eSpark-Backup/chrisbyrd-lightsptdevice/Design Files/LightSPT-Device-v1.0/Deliverables/Renderings/2D_C_View.PNG

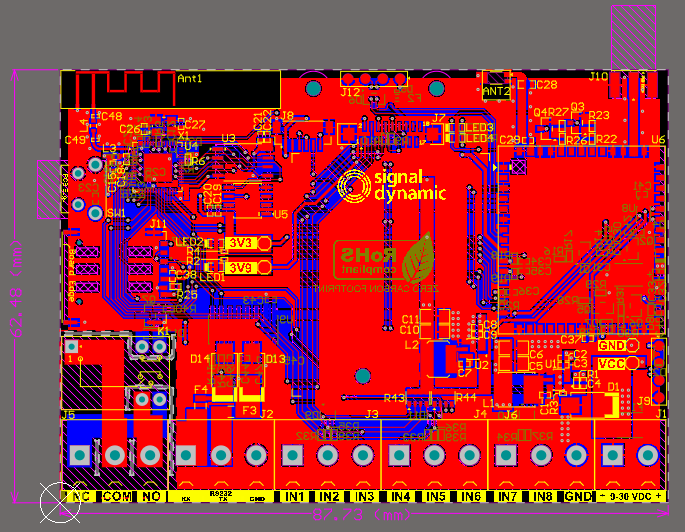
Design Files/LightSPT-Device-v1.0/Deliverables/Renderings/2D_C_View.PNG
