eSpark-Backup/chrisbyrd-lightsptdevice/Design Files/LightSPT-Device-v1.0/Deliverables/Renderings/2D_Top_Layer.PNG

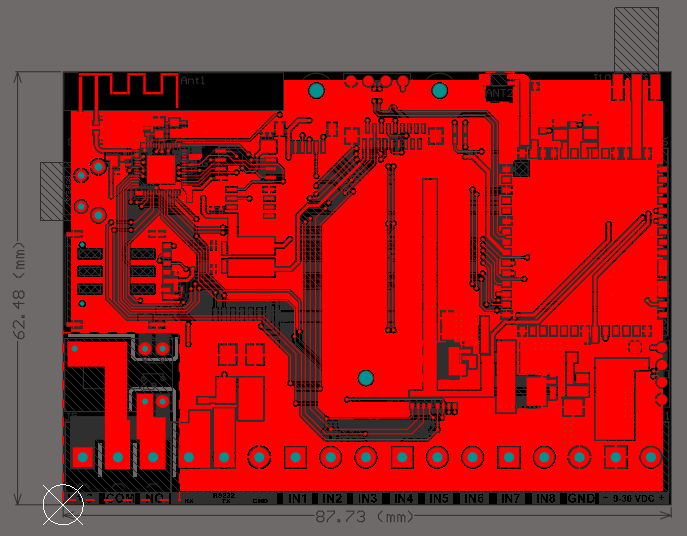
Design Files/LightSPT-Device-v1.0/Deliverables/Renderings/2D_Top_Layer.PNG
