eSpark-Backup/chrisbyrd-lightsptdevice/Design Files/LightSPT-Device-v1.0/Deliverables/Renderings/3D_Back Edge.PNG

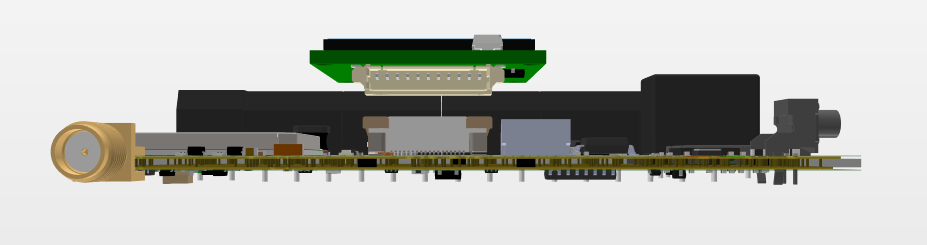
Design Files/LightSPT-Device-v1.0/Deliverables/Renderings/3D_Back Edge.PNG
