eSpark-Backup/chrisbyrd-lightsptdevice/Design Files/LightSPT-Device-v1.0/Deliverables/Renderings/3D_Isometric_View.png

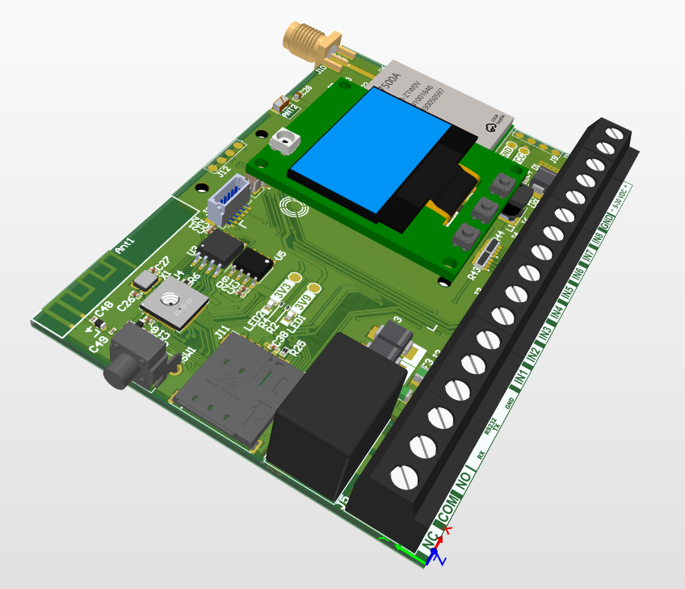
Design Files/LightSPT-Device-v1.0/Deliverables/Renderings/3D_Isometric_View.png
