eSpark-Backup/chrisbyrd-lightsptdevice/Design Files/LightSPT-Device-v1.0/Deliverables/Renderings/3D_Right Edge.PNG

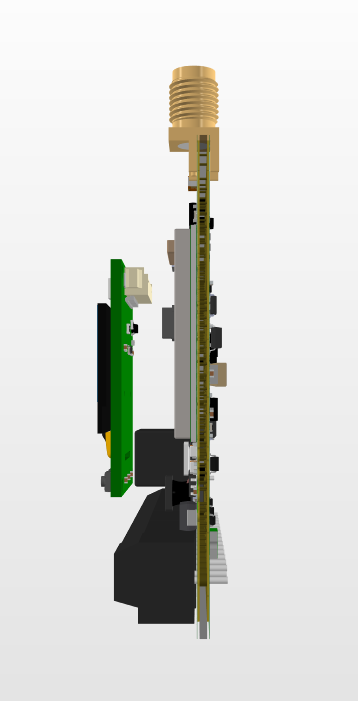
Design Files/LightSPT-Device-v1.0/Deliverables/Renderings/3D_Right Edge.PNG
