eSpark-Backup/chrisbyrd-lightsptdevice/Design Files/LightSPT-Device-v1.0/BOM/Client_BOM_Light_spt_device.xlsx

 |  | Component list |  | Bill of Materials for Project [Light_spt_device.]
 |  | Source Data From: |  | Light_spt_device.]
 |  | Project: |  | Light_spt_device.]
 |  | Variant: |  | None
# | Item Type | Designator | Description | Footprint | Manufacturer Part Number | Alternate Part Number | Manufacturer | Value | Quantity | Quantity (5 Boards) | Remarks
1 | Antenna | ~~ANT1~~ |  | ~~Custom~~ | ~~ANT*~~ | ~~-~~ | ~~-~~ | ~~-~~ | ~~1~~ | ~~5~~
2 | Antenna | ANT2 | RF ANT 1.575GHZ CHIP SOLDER SMD | Custom | W3011 | - | Pulse | - | 1 | 5
3 | Capacitor | C1, C3, C7, C9, C12, C17, C18, C19, C22, C23, C25, C32, C37, C38, C39, C40, C41, C42, C43, C44, C45, C46, C47 | CAP CER 0.1UF 100V X5R 0402 | Cap-0402 | GRM155R62A104KE14D | - | Murata | 0.1uf | 23 | 115
4 | Capacitor | C2, C8, C15, C20 | CAP CER 10UF 10V X5R 0402 | Cap-0402 | CL05A106MP5NUNC | - | Samsung | 10uF | 4 | 20
5 | Capacitor | C4 | CAP CER 100PF 50V C0G/NP0 0402 | Cap-0402 | GRM1555C1H101JA01D | - | Murata | 100pF | 1 | 5
6 | Capacitor | C5, C6, C10, C11 | CAP CER 22UF 25V X5R 1206 | Cap-1206 | 12063D226KAT2A |  | Kyocera AVX | 22uF | 4 | 20
7 | Capacitor | C13, C16, C21, C24, C33 | CAP CER 1UF 50V X5R 0402 | Cap-0402 | ~~UMK105CBJ105MV-F~~ | GRM155R61H105KE05D | Taiyo Yuden | 1uF | 5 | 25
8 | Capacitor | C14 | CAP CER 10000PF 50V X7R 0402 | Cap-0402 | CC0402KRX7R9BB103 | - | Yageo | 10nF | 1 | 5
9 | Capacitor | C26, C27, C34, C35, C36 | CAP CER 22PF 50V C0G/NPO 0402 | Cap-0402 | CC0402JRNPO9BN220 | - | Yageo | 22PF | 5 | 25
10 | Capacitor | C28 | CAP CER 2.2PF 50V C0G/NPO 0603 | Cap-0603 | CC0603CRNPO9BN2R2 | - | Yageo | 2.2pF | 1 | 5
11 | Capacitor | C29 | CAP CER 33PF 25V C0G/NP0 0402 | Cap-0402 | GRM1555C1E330JA01D | - | Murata | 33pF | 1 | 5
12 | Capacitor | C30 | CAP CER 0.022UF 16V X5R 0402 | Cap-0402 | CC0402KRX5R7BB223 | - | Yageo | 22nF | 1 | 5
13 | Capacitor | C31 | CAP TANT 220UF 20% 6.3V SMD | Case-B | TLJB227M006R0500 | - | Kyocera AVX | 220uF | 1 | 5
14 | Capacitor | C48 | CAP CER 2.7PF 50V C0G/NPO 0201 | CAP-0201 | CC0201CRNPO9BN2R7 | - | Yageo | 2.7pF | 1 | 5
15 | Capacitor | C49 | CAP CER 4.7PF 50V C0G/NPO 0201 | CAP-0201 | CC0201BRNPO9BN4R7 | - | Yageo | 4.7pF | 1 | 5
16 | Diode | D1 | 58.1V 40V 36V Bi-Directional SMB(DO-214AA) TVS ROHS | SMB_ | SMBJ36CA | - | Slkor(SLKORMICRO Elec.) | - | 1 | 5
17 | Diode | D2, D12 | DIODE GEN PURP 75V 150MA SOD323 | SOD-323 | 1N4148WS-7-F | - | Diodes | - | 2 | 10
18 | ESD Diode | D3 | 15V 19A 3.3V 4V Bidirectional SOD-323 ESD Protection Devices ROHS | SOD-323 | UDD32C03L01 | - | Brightking | - | 1 | 5
19 | Diode | D4 | DIODE ZENER 5.1V 500MW SOD123 | SOD-123 | MMSZ5231BT1G | - | ON Semiconductor | - | 1 | 5
20 | Diode | D5 | TVS DIODE 5VWM 6.3VC DSN0603-2 | DSN0603-2 | PESD5V0H1BSFYL | - | Nexperia | - | 1 | 5
21 | Diode | D6 | 16A 20V 7V 5V@Max Unidirectional SOT-23 TVS ROHS | Sot-23 | ESD5302F-3/TR | - | WILLSEMI | - | 1 | 5
22 | Diode | D7, D8 | 35A@8/20us 15V 4.5V@Max Unidirectional DFN1006 TVS ROHS | DFN1006-2L_ | ESD5651N-2/TR | - | WILLSEMI(Will Semicon) | - | 2 | 10
23 | Diode | D9, D10, D11 | DIODE ZENER ARRAY 3.3V SOT363 | SOT-363 | BZX84C3V3TS-7-F |  | Diodes Incorporated | - | 3 | 15
24 | Diode | D13, D14 | SMB(DO-214AA) TVS ROHS | SMB_ | SMBJ26CA | - | MSKSEMI | - | 2 | 10
25 | Fuse | F1 | 33V 1.5A 40A 3A 1812 Resettable Fuses ROHS | Fuse-1812_ | BSMD1812-150-33V | - | BHFUSE | - | 1 | 5
26 | Fuse | F2 | 6V 500mA 40A 1A 0603 Resettable Fuses ROHS | Fuse-0603 | SMD0603-050 | - | TECHFUSE | - | 1 | 5
27 | Fuse | F3, F4 | 9V 200mA 100A 500mA 0805 Resettable Fuses ROHS | Fuse-0805 | SMD0805P020TF | - | RUILON | - | 2 | 10
28 | Terminal Block | J1 | 1x2P 18A -40℃~+105℃ 250V Black 12~30 Straight pin 5.08mm 2.5 1 2 Plugin,P=5.08mm Screw terminal ROHS | Custom | DB128L-5.08-2P-BK-S | - | DIBO | - | 1 | 5
29 | Terminal Block | J2, J3, J4, J5, J6 | 1x3P 18A -40℃~+105℃ 250V Black 12~30 Straight pin 5.08mm 2.5 1 3 Plugin,P=5.08mm Screw terminal ROHS | Custom | DB128L-5.08-3P-BK-S | - | DIBO | - | 5 | 25
30 | Connector | J7 | Slide Lock 18P Contact, Vertical - One Side Brick nogging 0.5mm SMD,P=0.5mm FFC/FPC Connectors ROHS | Custom | F0503-ZV-18-20T-R | - | XFCN | - | 1 | 5
31 | Connector | J8 | 1x6P SH 1 1mm 6 SMD,P=1mm Wire To Board / Wire To Wire Connector ROHS | Custom | C145963 | - | BOOMELE | - | 1 | 5
32 | Pogo Connector | ~~J9, J12~~ | ~~Pogo Pad 2.5mm 4 Pin~~ | ~~Custom~~ | ~~POGO Connector 4 Pin~~ | ~~-~~ | ~~-~~ | ~~-~~ | ~~2~~ | ~~10~~
33 | SMA Connector | J10 | Sma Female Connector, Pcb Edge Mount Rohs Compliant: Yes | CON-SMA-EDGE_S | CON-SMA-EDGE-S |  | RF Solutions | - | 1 | 5
34 | SIM Card Connectors | J11 | Copper Alloy Self bomb Gold plating 1.25mm Deck -40℃~+85℃ 260℃ NanoSIM SMD SIM Card Connectors ROHS | Custom | XKNANO-113 | - | XKB Connectivity | - | 1 | 5
35 | Relay | K1 | RELAY GEN PURPOSE SPDT 3A 3V | Custom | J102K1CS33VDC.20 | - | CIT Relay & Switch | - | 1 | 5
36 | Inductor | L1 | FIXED IND 10UH 2.5A 79.3MOHM SMD | VLS5045EX-100M-H | VLS5045EX-100M-H | - | TDK | 10uH | 1 | 5
37 | Inductor | L2 | 2.7A 6.8uH ±20% 50mΩ SMD Power Inductors ROHS | Custom | LVC505040-6R8M-N | - | Chlisin Elec | 6.8uH | 1 | 5
38 | Inductor | L3 | 2nH ±0.3nH 0603 Inductors | IND-0603 (1608 Metric) | SDCL1608C2N0STDF | - | Sunlord | 2nH | 1 | 5
39 | Inductor | L4 | 700mA 1.6nH ±10% 40mΩ 0603 Inductors (SMD) ROHS | IND-0603 (1608 Metric) | FHW0603UC1N6KST | - | FH | 1.6nH | 1 | 5
40 | LED | LED1, LED2, LED4 | Red 632nm LED Indication - Discrete 2.05V 0603 (1608 Metric) | LED-0603 | 19-21/R7C-AK1L2BY/3T | - | Everlight Elec | - | 3 | 15
41 | LED | LED3 | Yellow-Green 572nm LED Indication - Discrete 2.05V 0603 (1608 Metric) | LED-0603 | 19-21/G6C-FM1N2B/3T | - | Everlight Elec | - | 1 | 5
42 | Test Point | ~~P1, P2, P3, P4~~ | ~~Test Point ON~~ | ~~Custom~~ | ~~Test-point~~ | ~~-~~ | ~~-~~ | ~~-~~ | ~~4~~ | ~~20~~
43 | Mosfet | Q1, Q3, Q4, Q5, Q6, Q7 | TRANS NPN 40V 0.6A SMD SOT23-3 | SOT-23 | MMBT2222A-7-F | - | Diodes | - | 6 | 30
44 | Mosfet | Q2 | 20V 2.2A 800mW 110mΩ@4.5V,2.7A 810mV@250uA P Channel SOT-23 MOSFETs ROHS | Sot-23 | WPM2015-3/TR | - | WILLSEMI | - | 1 | 5
45 | Resistor | R1 | RES 39K OHM 1% 1/16W 0402 | Res-0402 | RC0402FR-0739KL | - | Yageo | 39K | 1 | 5
46 | Resistor | R2, R4 | RES 470 OHM 5% 1/20W 0201 | Res-0201 | ~~RC0201JR-07470RL~~ | RC-01W471JT | Yageo | 470R | 2 | 10
47 | Resistor | R3, R8, R11, R12, R13, R15 | RES SMD 10K OHM 1% 1/20W 0201 | Res-0201 | RC0201FR-0710KL | - | Yageo | 10K | 6 | 30
48 | Resistor | R5 | RES 499 OHM 1% 1/16W 0402 | Res-0402 | RC0402FR-07499RL | - | Yageo | 499R | 1 | 5
49 | Resistor | R6, R7, R16, R22, R25, R26, R28, R30, R32, R33, R34, R35, R36, R37, R38, R39, R40 | RES 4.7K OHM 1% 1/16W 0402 | Res-0402 | RC0402FR-074K7L | - | Yageo | 4.7K | 17 | 85
50 | Resistor | R9, R10, R19 | RES 0 OHM JUMPER 1/16W 0402 | Res-0402 | RC0402FR-070RL | - | Yageo | 0R | 3 | 15
51 | Resistor | R14 | RES 1K OHM 5% 1/16W 0402 | Res-0402 | RC0402JR-071KL | - | Yageo | 1K | 1 | 5
52 | Resistor | R17, R23, R27, R29, R31 | RES 47K OHM 1% 1/16W 0402 | Res-0402 | RC0402FR-0747KL | - | Yageo | 47K | 5 | 25
53 | Resistor | R18, R20, R41, R42 | RES SMD 22 OHM 1% 1/5W 0402 | Res-0402 | ~~RCS040222R0FKED~~ | 0402WGJ0220TCE | Vishay Dale | 22R | 4 | 20
54 | Resistor | R21, R24 | RES 180 OHM 1% 1/10W 0603 | Res-0603 | RC0603FR-07180RL | - | Yageo | 180R | 2 | 10
55 | Resistor | R43, R44 | RES ARRAY 4 RES 100K OHM 1206 | Custom | YC164-JR-07100KL | - | Yageo | 100K | 2 | 10
56 | Tactile Switch | SW1 | 50mA Lying SPST 24V Plugin Tactile Switches ROHS | Custom | 1825027-8 | - | TE Connectivity | - | 1 | 5
57 | IC | U1 | IC REG BUCK ADJUSTABLE 2A TSOT26 | TSOT-26-6 | AP63200WU-7 | - | Diodes | - | 1 | 5
58 | IC | U2 | IC REG BUCK 3.3V 2A TSOT26 | TSOT-23-6 | AP63203WU-7 | - | Diodes | - | 1 | 5
59 | IC | U3 | IC FLASH 64M SPI 133MHZ 8SOIC | SOIC-8 (208 mil) | W25Q64JVSSIQ TR | - | Winbond | - | 1 | 5
60 | IC | U4 | SMD IC ESP32-S3R8, DUAL-CORE MCU | 56-QFN (7x7) | ESP32-S3R8 | - | Espressif Systems | - | 1 | 5
61 | IC | U5 | IC AUTHENTICATION CHIP 8SOIC | SOIC-8 | ATECC608B-SSHDA-B |  | Microchip | - | 1 | 5
62 | IC | U6 | SMD,30x30mm 2G/3G/4G/5G Modules ROHS | Custom | SIM7500E | - | SIMCom | - | 1 | 5
63 | ESD Diode | U7 | 15V 5 Unidirectional 5V SOT-363 ESD Protection Devices ROHS | SOT-363 | SMF05CT1G-ES | - | ElecSuper | - | 1 | 5
64 | IC | U8 | IC TRNSLTR BIDIRECTIONAL US8 | VSSOP-8(2x2.3x0.5) | TXB0102DCUT | - | Texas Instruments | - | 1 | 5
65 | IC | U9 | IC TRANSCEIVER FULL 2/2 16SOIC | SOIC-16 | MAX3232IDR | - | Texas Instruments | - | 1 | 5
66 | Crystal | X1 | 40MHz SMD Crystal Resonator 15pF SMD3225-4P Crystals ROHS | Custom | X322540MPB4SI | - | Yangxing Tech | 40MHz | 1 | 5
67 | Peripheral | - | 1.8 3dBi Vertical 50W - Antennas ROHS | - | BWGSMJWX105-7KJ | - | BAT WIRELESS | - | 1 | 5
68 | Peripheral | - |  | - | USB Type A to A Cable | - | - | - | 1 | 5 | Refrence Link (https://vi.aliexpress.com/item/1005004386493582.html?pdp_np)
