eSpark-Backup/chrisbyrd-lightsptdevice/Design Files/LightSPT-Device-v1.0/Deliverables/Supporting Files/Light_SPT_Device_v1.0.DXF

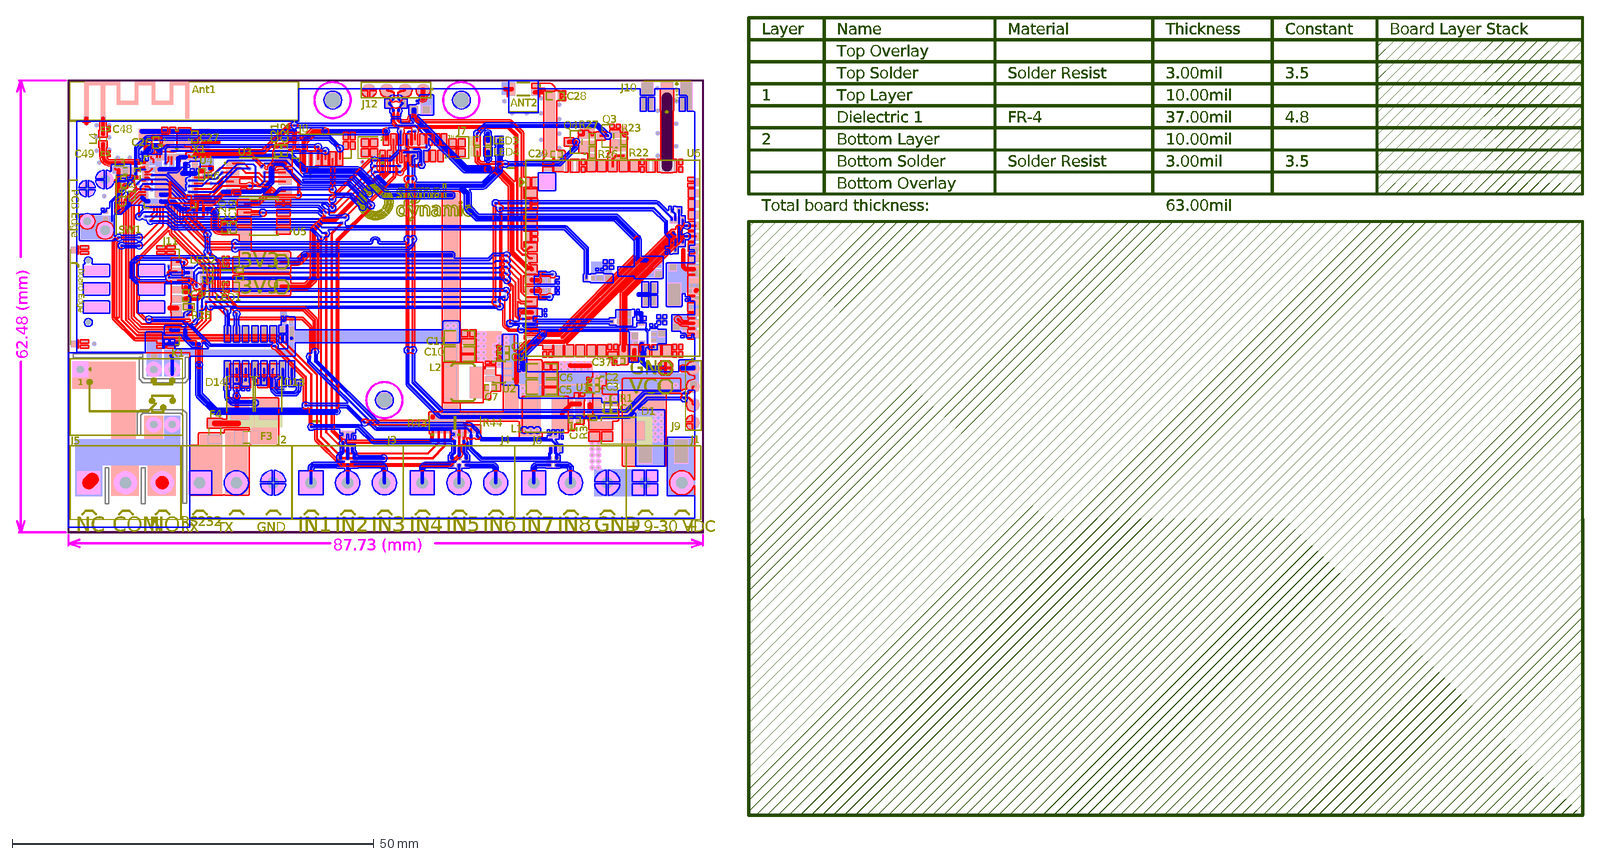
[picture p11: CAD file, 2023-10-12]
Design Files/LightSPT-Device-v1.0/Deliverables/Supporting Files/Light_SPT_Device_v1.0.DXF
IN8
GND
TX
RS232
IN3
COM
VCC
+
IN2
IN1
RX
NC
9-30 VDC
NO
3V3
IN7
IN5
3V9
IN6
IN4
63.00mil
Total board thickness:
Board Layer Stack
3.5
4.8
Constant
3.00mil
10.00mil
37.00mil
Thickness
Solder Resist
FR-4
Material
Top Overlay
Top Solder
Top Layer
Dielectric 1
Bottom Layer
Bottom Solder
Bottom Overlay
Name
1
2
Layer
87.73 (mm)
62.48 (mm)
L4
C49
C48
Ant1
C18
Board Edge
J11
L1
X1
U6
U5
U4
U3
U2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
