eSpark-Backup/chrisbyrd-lightsptdevice/(list of files, cad)

Other CAD files:
Design Files/LightSPT-Device-v1.0/Deliverables/Supporting Files/Light_SPT_Device_v1.0.DWG
