eSpark-Backup/chrisbyrd-lightsptdevice/Design Files/LightSPT-Device-v1.0/Deliverables/Schematics/Light_SPT_Device_v1.0.pdf

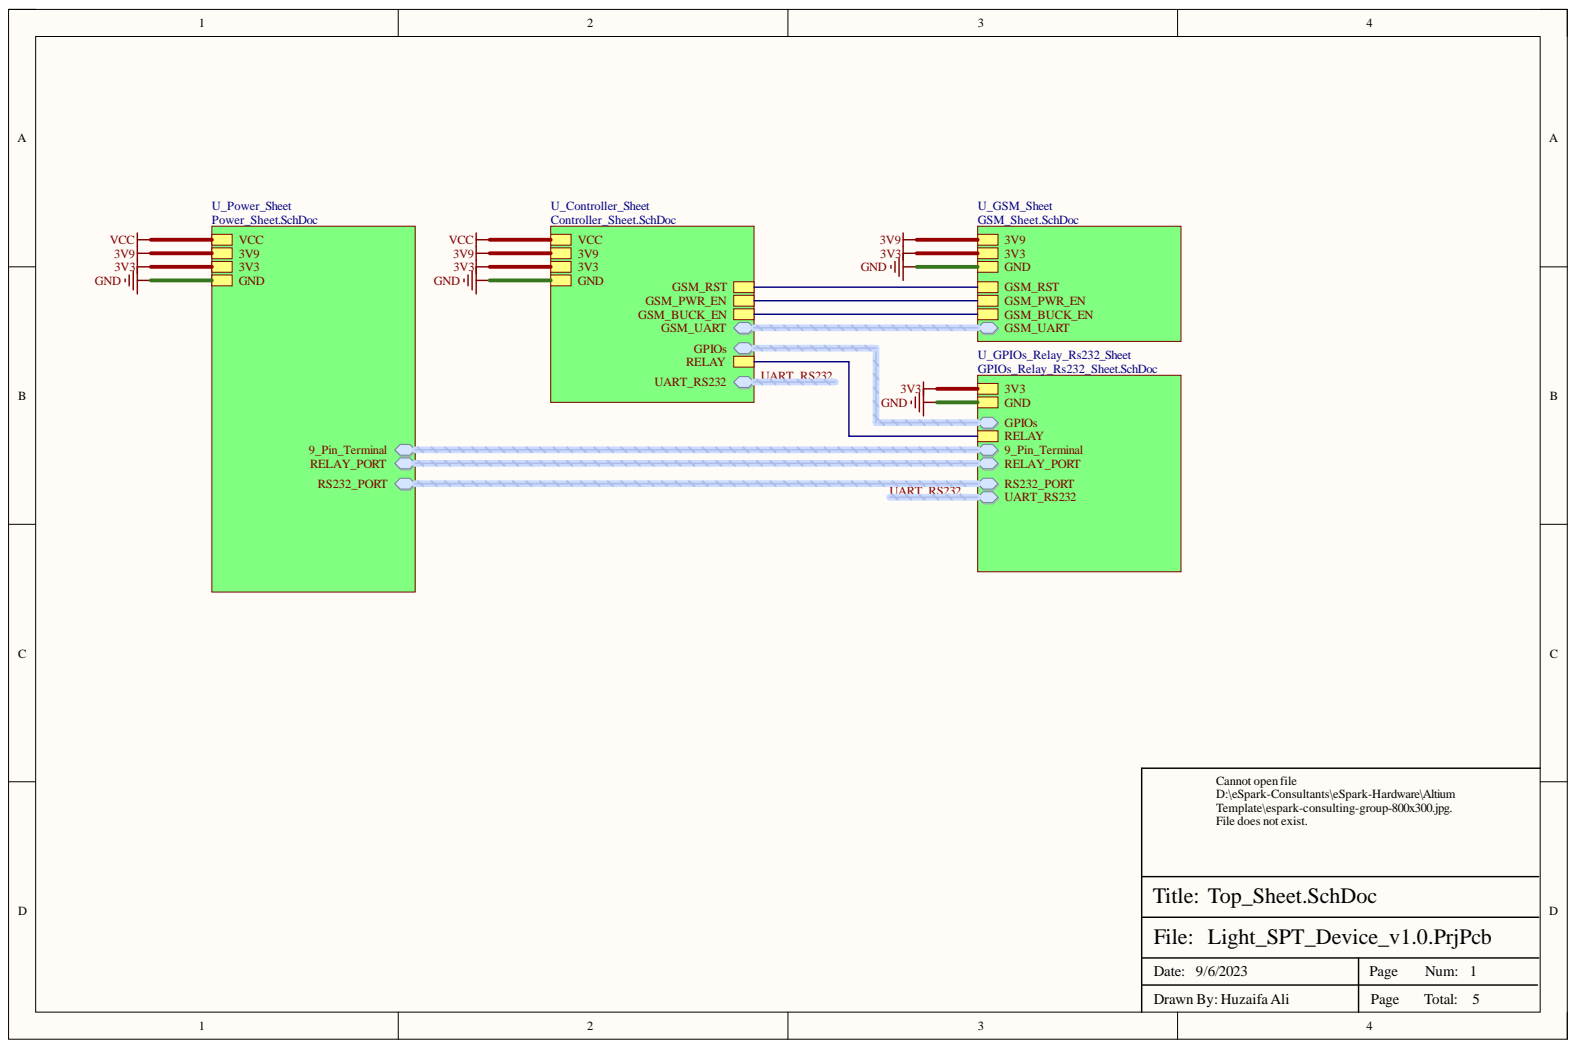
[picture p12: page 1]

Cannot open file
D:\eSpark-Consultants\eSpark-Hardware\Altium
Template\espark-consulting-group-800x300.jpg.
File does not exist.

Date: 9/6/2023 | Page Num: 1

Drawn By: Huzaifa Ali | Page Total: 5

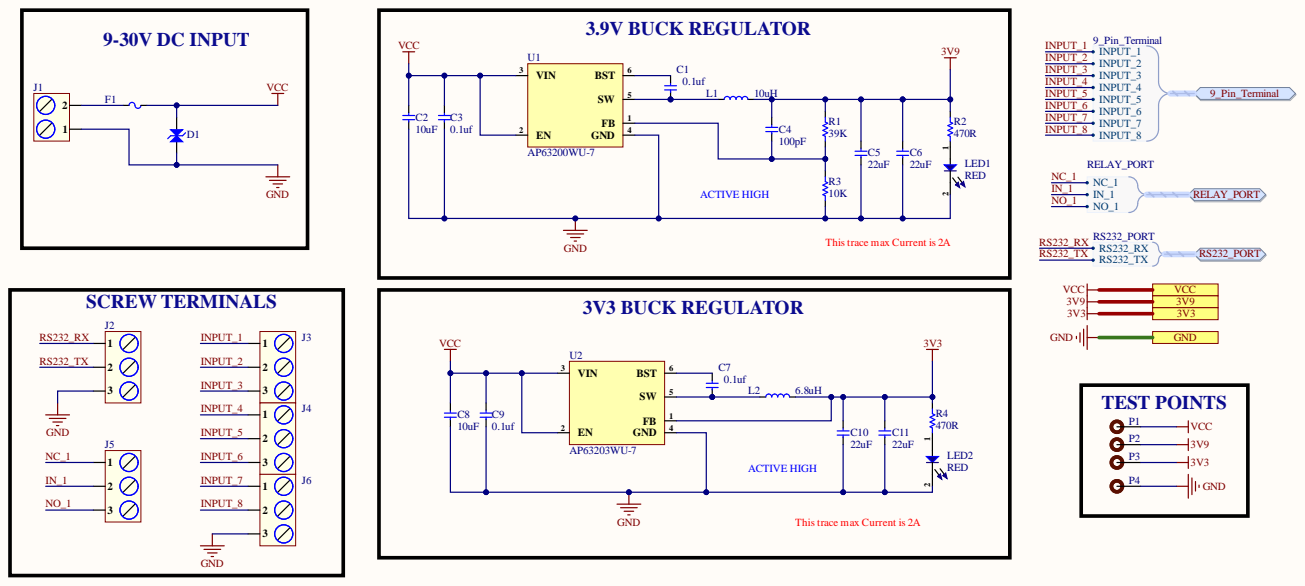
[picture p13: page 2]

Can
D:\eSpark-Consultan
Template\espark-consulting-grou
File does

Date : 9/6/2 0 2 3 | P a g e Nu m : 25

Drawn By: Hu z aifa Ali | P a g e T ota l :

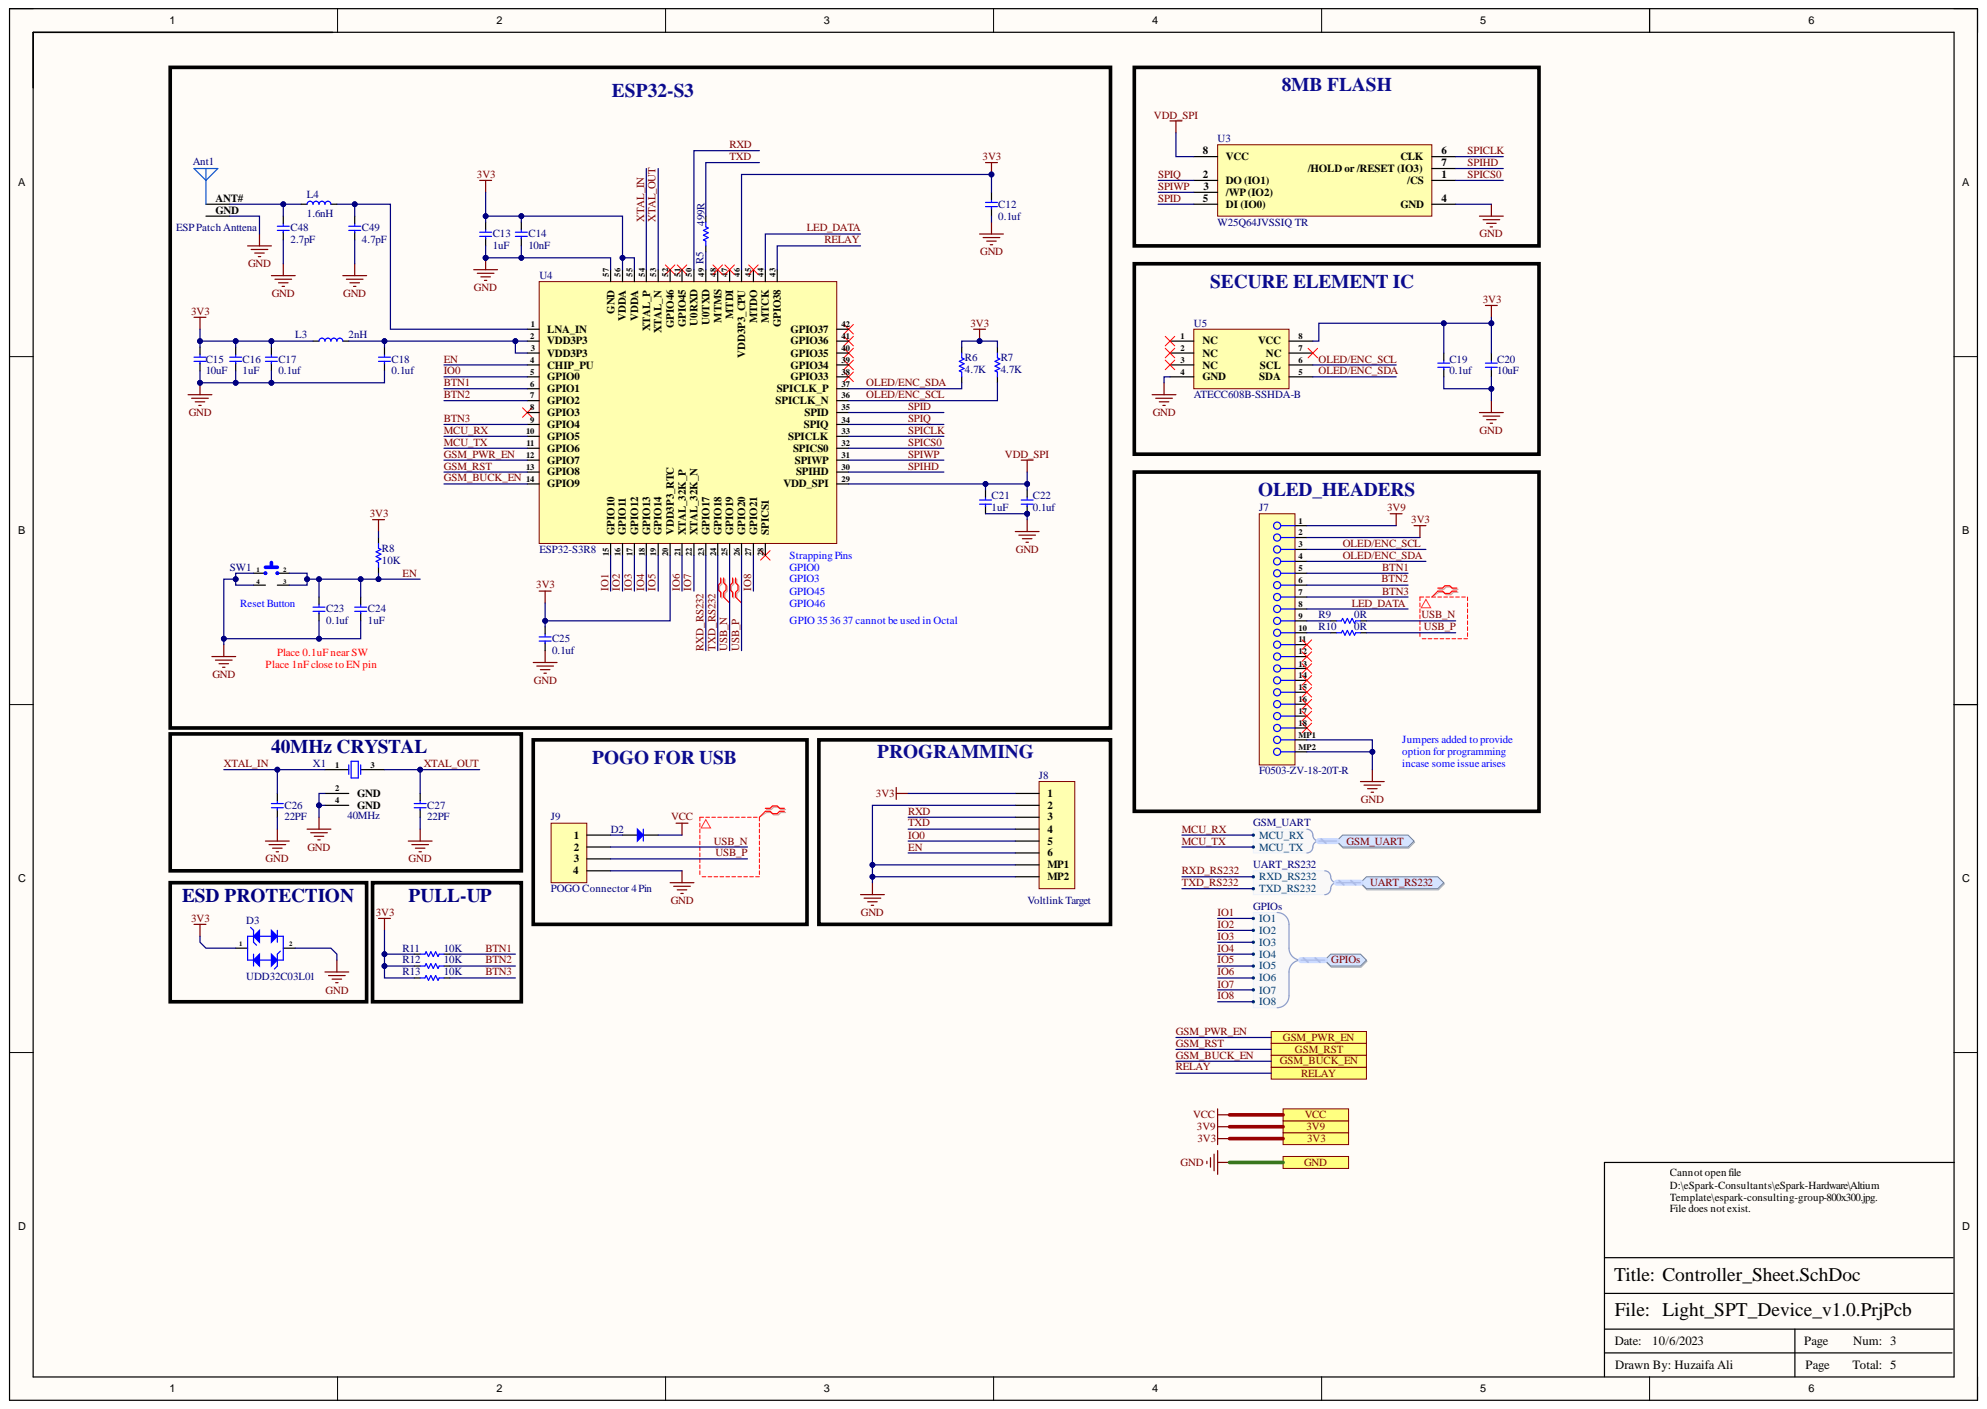
[picture p14: page 3]

42 PIO38 43 MTCK 44 MTDO 45 VDD3P3_CPU 46 MTDI 47 MTMS 48 U0TXD 49 U0RXD 50 GPIO45 51 GPIO46 52 XTAL_N 53 XTAL_P 54 VDDA 55 VDDA 56 GND 57

Place 0.1uF near SW
Place 1nF close to EN pin

Jumpers added to provide
option for programming
incase some issue arises

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

Date: 10/6/2023 | Page Num: 3

Drawn By: Huzaifa Ali | Page Total:

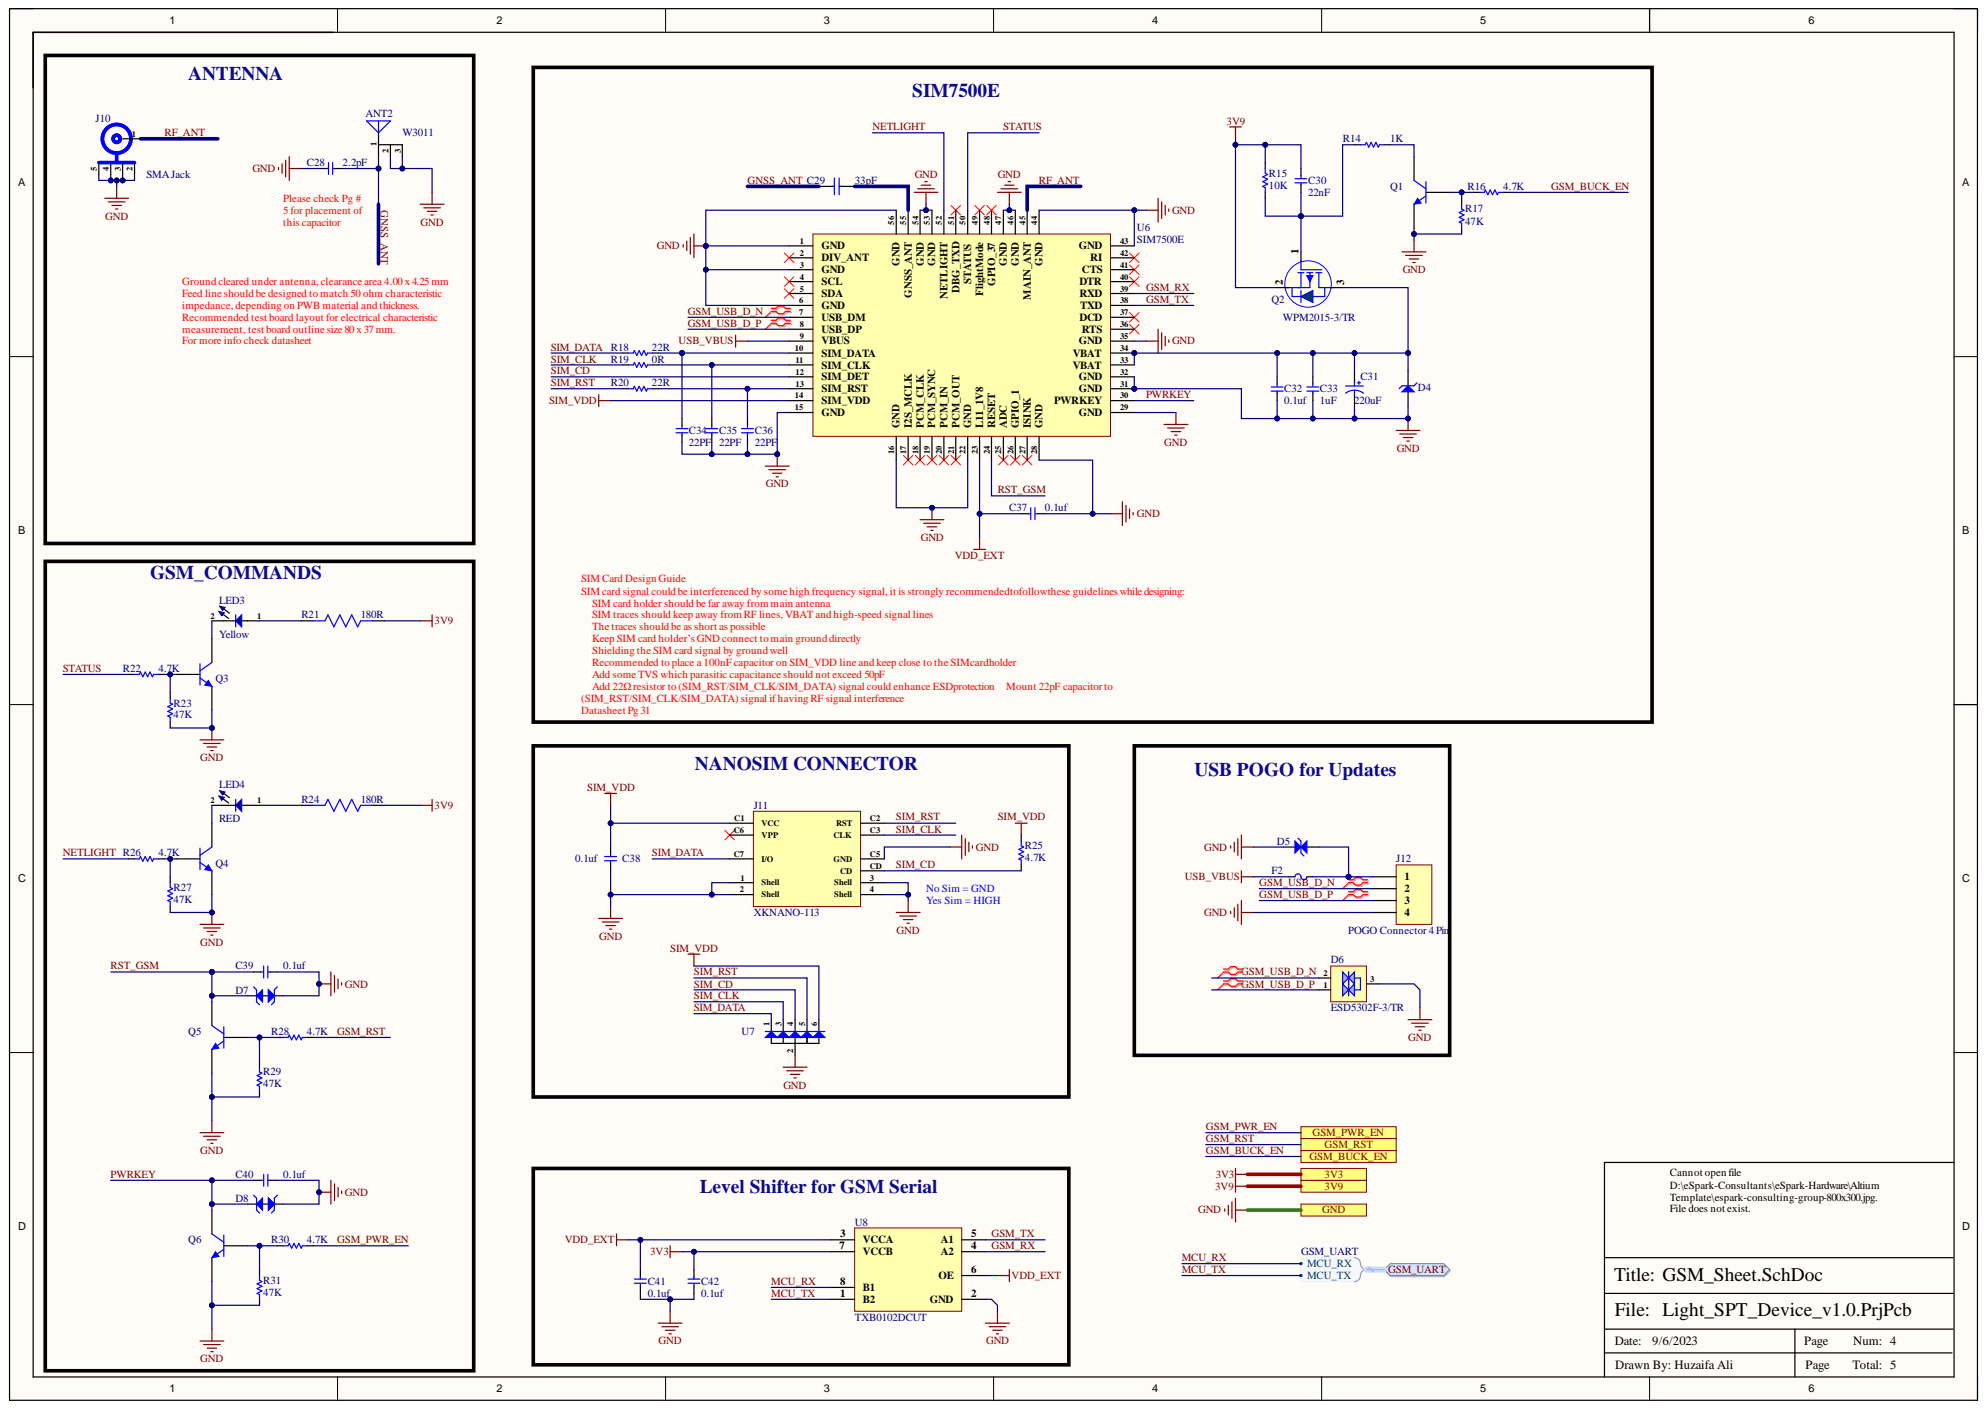
[picture p15: page 4]

GND 44 MAIN_ANT 45 GND 46 GND 47 GPIO_37 48 FlightMode 49 STATUS 50 DBG_TXD 51 NETLIGHT 52 GND 53 GND 54 GNSS_ANT 55 GND 56

Ground cleared under antenna, clearance area 4.00 x 4.25 mm
Feed line should be designed to match 50 ohm characteristic
impedance, depending on PWB material and thickness.
Recommended test board layout for electrical characteristic
measurement, test board outline size 80 x 37 mm.
For more info check datasheet

SIM Card Design Guide
SIM card signal could be interferenced by some high frequency signal, it is strongly recommendedtofollowthese guidelines while designing:
SIM card holder should be far away from main antenna
SIM traces should keep away from RF lines, VBAT and high-speed signal lines
The traces should be as short as possible
Keep SIM card holder’s GND connect to main ground directly
Shielding the SIM card signal by ground well
Recommended to place a 100nF capacitor on SIM_VDD line and keep close to the SIMcardholder
Add some TVS which parasitic capacitance should not exceed 50pF
Add 22Ωresistor to (SIM_RST/SIM_CLK/SIM_DATA) signal could enhance ESDprotection Mount 22pF capacitor to
(SIM_RST/SIM_CLK/SIM_DATA) signal if having RF signal interference
Datasheet Pg 31

USB POGO for Updates

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

Level Shifter for GSM Serial

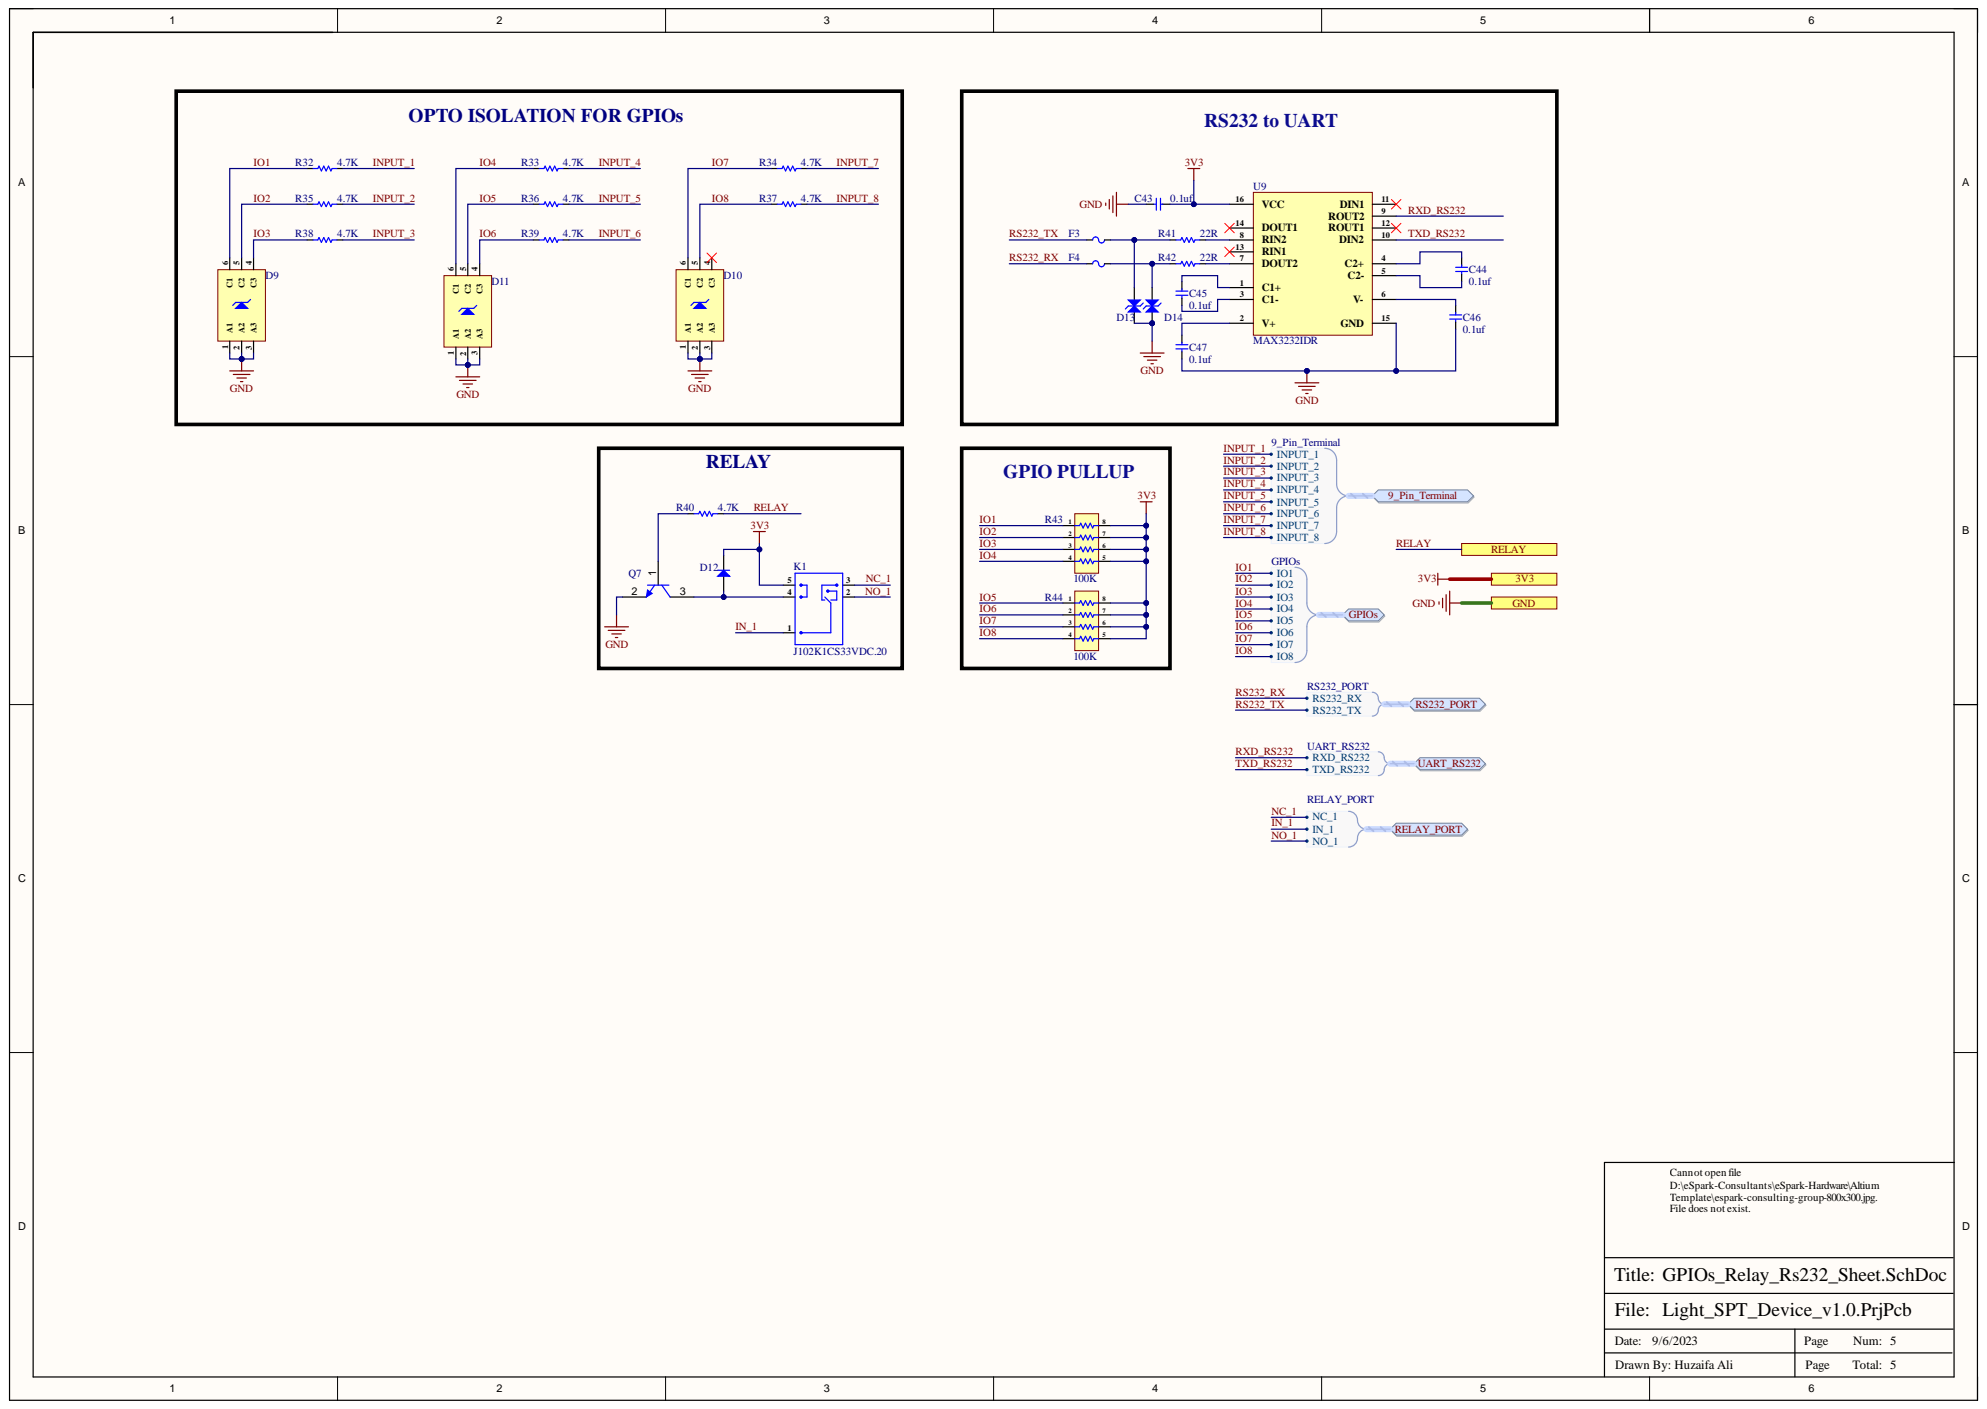
[picture p16: page 5]

OPTO ISOLATION FOR GPIOs

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
