eSpark-Backup/chrisbyrd-lightsptdevice/Design Files/LightSPT-Device-v1.0/Deliverables/Schematics/Assembly Drawings.pdf

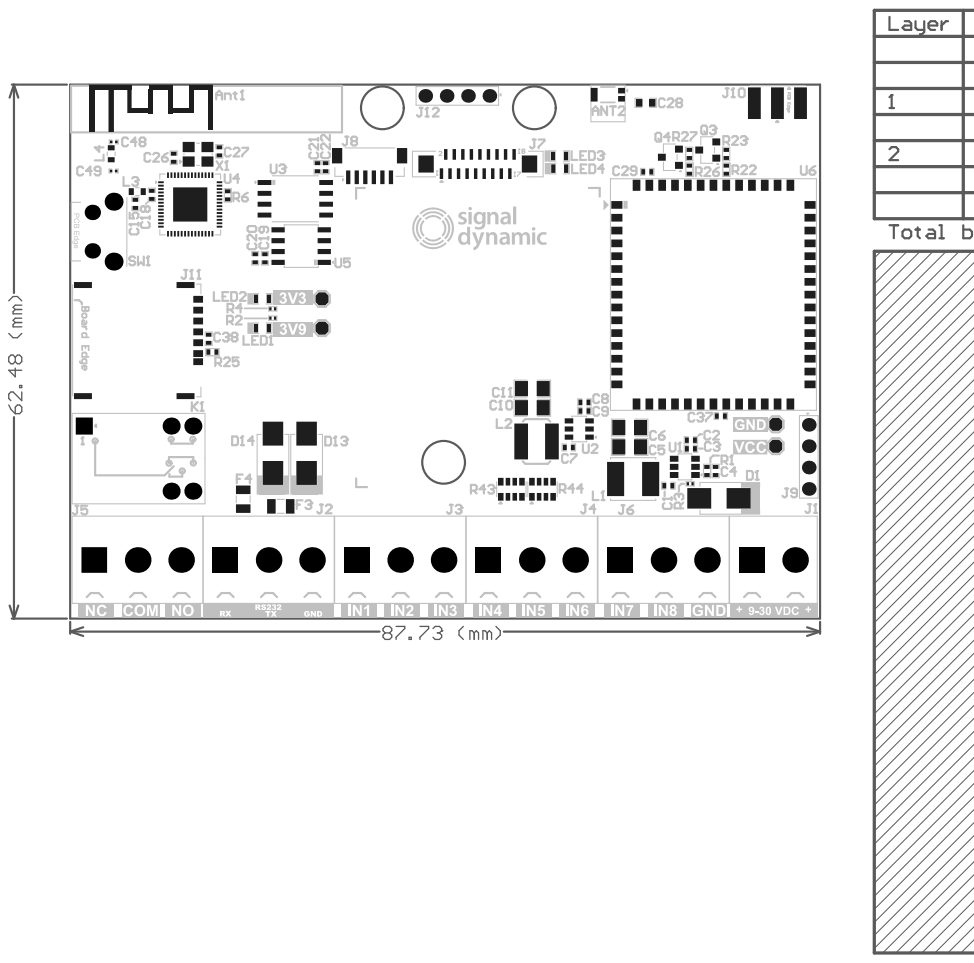
[picture p17: page 1]

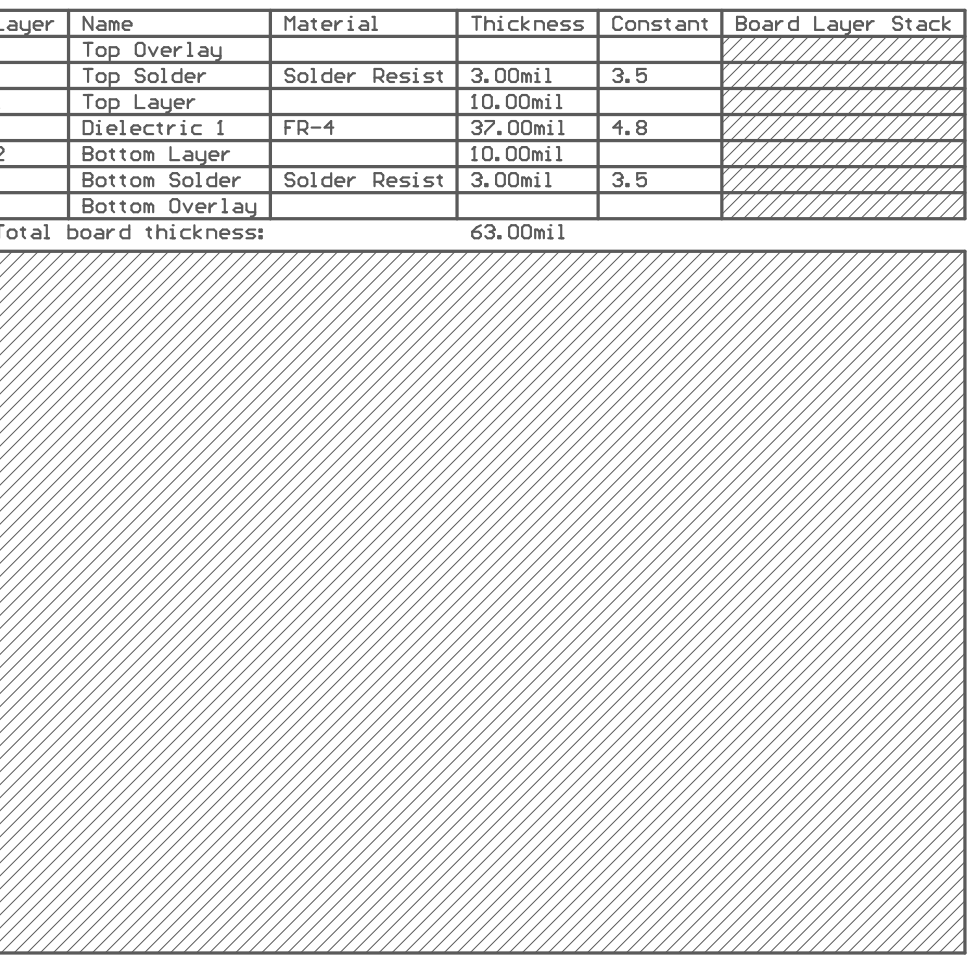
[picture p18: page 2]

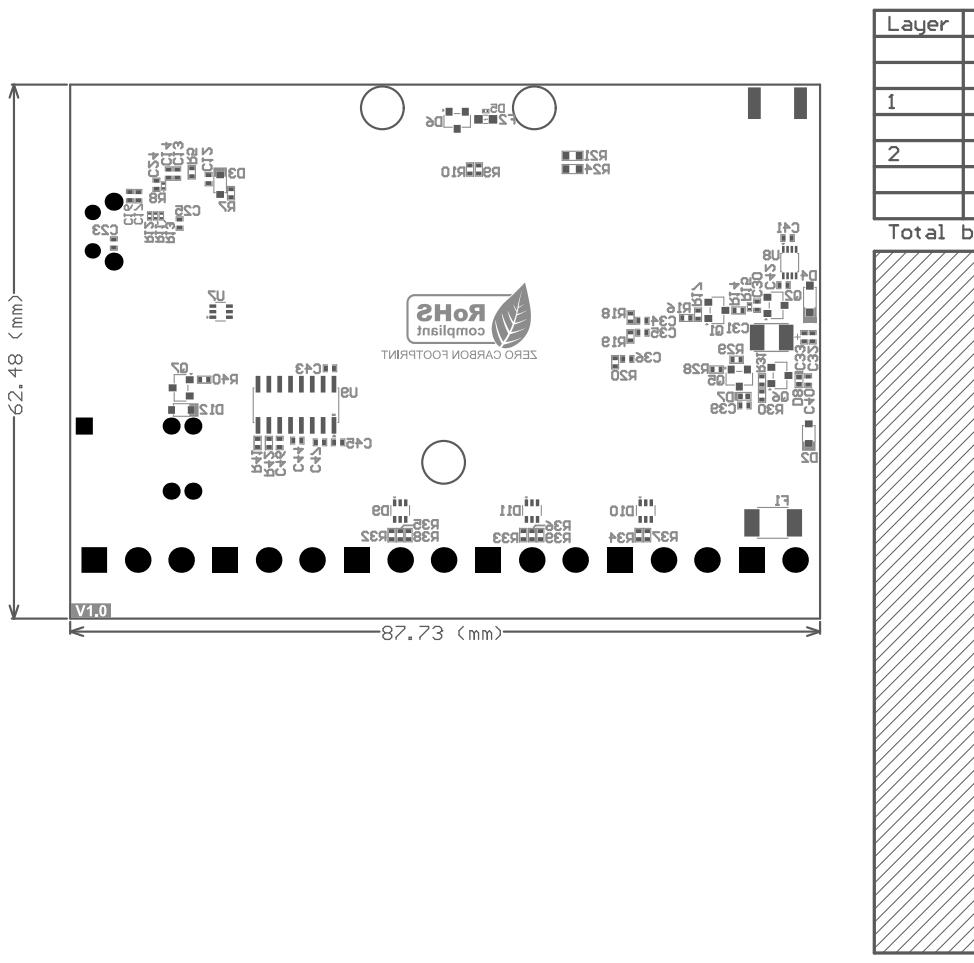
[picture p19: page 3]
