eSpark-Backup/chrisbyrd-lightsptdevice/(list of files, drawings)

Other design files:
Design Files/Light_spt_device/Light_spt_device.PrjPcb
Design Files/LightSPT-Device-v1.0/Controller_Sheet.SchDoc
Design Files/LightSPT-Device-v1.0/GPIOs_Relay_Rs232_Sheet.SchDoc
Design Files/LightSPT-Device-v1.0/GSM_Sheet.SchDoc
Design Files/LightSPT-Device-v1.0/Light_SPT_Device_v1.0.PcbDoc
Design Files/LightSPT-Device-v1.0/Light_SPT_Device_v1.0.PrjPcb
Design Files/LightSPT-Device-v1.0/Power_Sheet.SchDoc
Design Files/LightSPT-Device-v1.0/Top_Sheet.SchDoc
