eSpark-Backup/chrisbyrd-lightsptdevice/(commit log)

2023-07-04 #1 Schematic in Progress
    [GSM_Sheet.SchDoc, Light_spt_device.PrjPcb, Sheet1.SchDoc, Sheet2.SchDoc]
2023-07-05 #1 Except Power_Sheet Schematic Completed
    [Connector_Sheet.SchDoc, Controller_Sheet.SchDoc, GSM_Sheet.SchDoc, Light_spt_device.PrjPcb, Power_Sheet.SchDoc, RS232_Sheet.SchDoc, Sheet1.SchDoc, Sheet2.SchDoc]
2023-07-06 #1 Schematic Design completed
    [Connector_Sheet.SchDoc, Controller_Sheet.SchDoc, GPIOs_Relay_Sheet.SchDoc, GSM_Sheet.SchDoc, Light_spt_device.PrjPcb, Power_Sheet.SchDoc, RS232_Sheet.SchDoc, Sheet2.SchDoc]
2023-07-07 #1 Sheets cleaned
    [Controller_Sheet.SchDoc, GPIOs_Relay_Sheet.SchDoc, GSM_Sheet.SchDoc, Power_Sheet.SchDoc, RS232_Sheet.SchDoc]
2023-07-10 #2 #1 Recommended changes done
    [GPIOs_Relay_Sheet.SchDoc, GSM_Sheet.SchDoc, Power_Sheet.SchDoc]
2023-07-10 #1 #2 Top Sheet adjusted
    [GPIOs_Relay_Sheet.SchDoc, Power_Sheet.SchDoc, RS232_Sheet.SchDoc, Top_Sheet.SchDoc]
2023-07-12 #3 Parts Placement in Progress
    [Controller_Sheet.SchDoc, GSM_Sheet.SchDoc, Light_spt_device.PcbDoc, Light_spt_device.PrjPcb, Power_Sheet.SchDoc, RS232_Sheet.SchDoc]
2023-07-13 Placement done, Dimensions need to confirm for client
    [Controller_Sheet.SchDoc, GPIOs_Relay_Sheet.SchDoc, GSM_Sheet.SchDoc, Light_spt_device.PcbDoc, Power_Sheet.SchDoc, RS232_Sheet.SchDoc, Top_Sheet.SchDoc]
2023-07-20 #1 Project renamed
    [Light_spt_device_v-1.0.PrjPcb]
2023-07-20 Folder renamed #1
    [Controller_Sheet.SchDoc, GPIOs_Relay_Sheet.SchDoc, GSM_Sheet.SchDoc, Light_spt_device.PcbDoc, Light_spt_device_v-1.0.PrjPcb, Power_Sheet.SchDoc, RS232_Sheet.SchDoc, Top_Sheet.SchDoc]
2023-07-20 #3 #1 Sheets merged (GPIO_Relay_Sheet and RS232_Sheet)
    [GPIOs_Relay_Rs232_Sheet.SchDoc, GPIOs_Relay_Sheet.SchDoc, Light_spt_device_v-1.0.PrjPcb, RS232_Sheet.SchDoc, Top_Sheet.SchDoc]
2023-07-20 #1 Top sheet template added
    [Top_Sheet.SchDoc]
2023-07-20 #1 PDF added
    [Controller_Sheet.SchDoc, Light_spt_device_v-1.0.PrjPcb]
2023-07-20 #4 eSpark and Client BOM Completed.
    [Client_BOM_Light_spt_device.xlsx, eSpark_BOM_Light_spt_device.xlsx]
2023-07-20 BOM uploaded in correct folder #4
    [Client_BOM_Light_spt_device.xlsx, eSpark_BOM_Light_spt_device.xlsx]
2023-07-21 #3 Single sided Placement complete(Dimension=91.85mm*67mm)
    [GPIOs_Relay_Rs232_Sheet.SchDoc, Light_spt_device.PcbDoc, Light_spt_device_v-1.0.PrjPcb, Power_Sheet.SchDoc]
2023-07-21 #1 #3 #4 L1 replaced
    [Power_Sheet.SchDoc]
2023-07-21 L1 updated in PCB(double side PCB-Placement in Progress)
    [Light_spt_device(double_sided).PcbDoc, Light_spt_device.PcbDoc, Light_spt_device_v-1.0.PrjPcb]
2023-07-24 Parts Placement completed #3
    [Light_spt_device(double_sided).PcbDoc, Light_spt_device_v-1.0.PrjPcb]
2023-07-25 #3 #1 J10 SMA connector replaced
    [GSM_Sheet.SchDoc]
2023-07-25 SMA Updated in PCB #3 Routing in Progress
    [Light_spt_device(double_sided).PcbDoc, Light_spt_device.PcbDoc]
2023-07-26 Routing in Progress
    [Light_spt_device(double_sided).PcbDoc]
2023-07-27 #3 Routing in Progress
    [Light_spt_device(double_sided).PcbDoc]
2023-07-31 #3 in Progress Five routes remaining, Shielding vias remaining
    [Light_spt_device(double_sided).PcbDoc, Light_spt_device_v-1.0.PrjPcb]
2023-08-01 #3 Routing completed, no drc error
    [Light_spt_device(double_sided).PcbDoc, Light_spt_device.PcbDoc]
2023-08-02 Vias added for heat dissipation, some routes corrected
    [Controller_Sheet.SchDoc, GPIOs_Relay_Rs232_Sheet.SchDoc, GSM_Sheet.SchDoc, Light_spt_device(double_sided).PcbDoc, Light_spt_device_v-1.0.PrjPcb, Power_Sheet.SchDoc, Top_Sheet.SchDoc]
2023-08-02 #4 Client BOM Updated.
    [Client_BOM_Light_spt_device.xlsx, eSpark_BOM_Light_spt_device.xlsx]
2023-08-03 un-routed net Error removed, no drc error
    [Light_spt_device(double_sided).PcbDoc]
2023-08-03 #5 In-Progress (GSM and GPIO, Relay sheet remaining).
    [Light_spt_device(double_sided).PcbDoc, Light_spt_device_v-1.0.PrjPcb]
2023-08-04 #127 Routing in Progress
    [Light_spt_device(double_sided).PcbDoc, Light_spt_device_v-1.0.PrjPcb]
2023-08-04 Revert "#127 Routing in Progress"
    This reverts commit 5341068a7d29b93845874507fa63eddfa36d55e5.
    [Light_spt_device(double_sided).PcbDoc, Light_spt_device_v-1.0.PrjPcb]
2023-08-04 #3 #1 #2 ESP Antenna replaced
    [Controller_Sheet.SchDoc]
2023-08-04 #5 Changes in PCB in-progress.
    [Light_spt_device(double_sided).PcbDoc, Light_spt_device_v-1.0.PrjPcb]
2023-08-07 #5 power circuitry adjusted, Antenna updated in PCB
    [Controller_Sheet.SchDoc, Light_spt_device(double_sided).PcbDoc]
2023-08-07 #5 Routing Completed: Designator and some other formatting remaining.
    [Controller_Sheet.SchDoc, Light_spt_device(double_sided).PcbDoc, Light_spt_device_v-1.0.PrjPcb]
2023-08-08 #5 USB Differential Rule implemented:
    [Light_spt_device(double_sided).PcbDoc]
2023-08-09 #5 Review Done.
    [Light_spt_device(double_sided).PcbDoc]
2023-08-09 #5 Deliverables generated.
    [Centroid_Files_v1.0.csv, Light_SPT_Device_v1.0.DWG, Light_SPT_Device_v1.0.DXF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]
2023-08-10 Overlay adjusted according to client request, and client logo added
    [Centroid_File.csv, Centroid_Files_v1.0.csv, Light_SPT_Device_v1.0.DWG, Light_SPT_Device_v1.0.DXF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]
2023-08-10 #5 Fresh Deliverables generated after modification for D6.
    [Centroid_File.csv, Light_SPT_Device_v1.0.DWG, Light_SPT_Device_v1.0.DXF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]
2023-08-24 #4 #3 C15 replaced with 10uf
    [Controller_Sheet.SchDoc]
2023-08-28 #3 #5 Fresh Deliverables generated after change of C15 in PCB.
    [Light_SPT_Device_v1.0.DWG, Light_SPT_Device_v1.0.DXF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]
2023-08-31 changes updated in PCB according to review
    [Light_SPT_Device_v1.0.PcbDoc]
2023-09-01 Clearance area updated
    [Light_SPT_Device_v1.0.PcbDoc]
2023-09-06 #5 Cut-out increased and fresh deliverables generated.
    [Centroid_Files_v1.0.csv, Controller_Sheet.SchDoc, GPIOs_Relay_Rs232_Sheet.SchDoc, GSM_Sheet.SchDoc, Light_SPT_Device_v1.0.DWG, Light_SPT_Device_v1.0.DXF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]
2023-10-06 #1 #4 #5 C48 and C49 and L4 added for antenna
    [Controller_Sheet.SchDoc]
2023-10-06 #4 eSpark And Client BOM updated.
    [Client_BOM_Light_spt_device.xlsx, eSpark_BOM_Light_spt_device.xlsx]
2023-10-09 #3 #5 Changes done in PCB and deliverables generated after changes.
    [Centroid File.csv, Light_SPT_Device_v1.0.DWG, Light_SPT_Device_v1.0.DXF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]
2023-10-12 #5 Fresh Deliverables generated.
    [Centroid File.csv, Centroid_File_v1.0.csv, Light_SPT_Device_v1.0.DWG, Light_SPT_Device_v1.0.DXF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]
2023-12-22 #4 eSpark And Client BOM Peripheral Added
    [Client_BOM_Light_spt_device.xlsx, eSpark_BOM_Light_spt_device.xlsx]
2024-02-16 #7 #8 Relay Footprint and Voltlink Connection Updated.
    [Centroid.csv, Controller_Sheet.SchDoc, GPIOs_Relay_Rs232_Sheet.SchDoc, JLCPCB-BOM-Light_SPT_Device_v1.0.xlsx, Light_SPT_Device_v1.0.DWG, Light_SPT_Device_v1.0.DXF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]
2024-02-19 Revert "#7 #8 Relay Footprint and Voltlink Connection Updated."
    This reverts commit c47edf4379a0ce0224118d32c857ec5416454c83.
    [Centroid_File_v1.0.csv, Controller_Sheet.SchDoc, GPIOs_Relay_Rs232_Sheet.SchDoc, JLCPCB-BOM-Light_SPT_Device_v1.0.xlsx, Light_SPT_Device_v1.0.DWG, Light_SPT_Device_v1.0.DXF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]
